RepkaWisthi/VESC-V.2/reference/bldc-hardware-master/bldc-hardware-master/design/PNGs/B_Modules-1.png

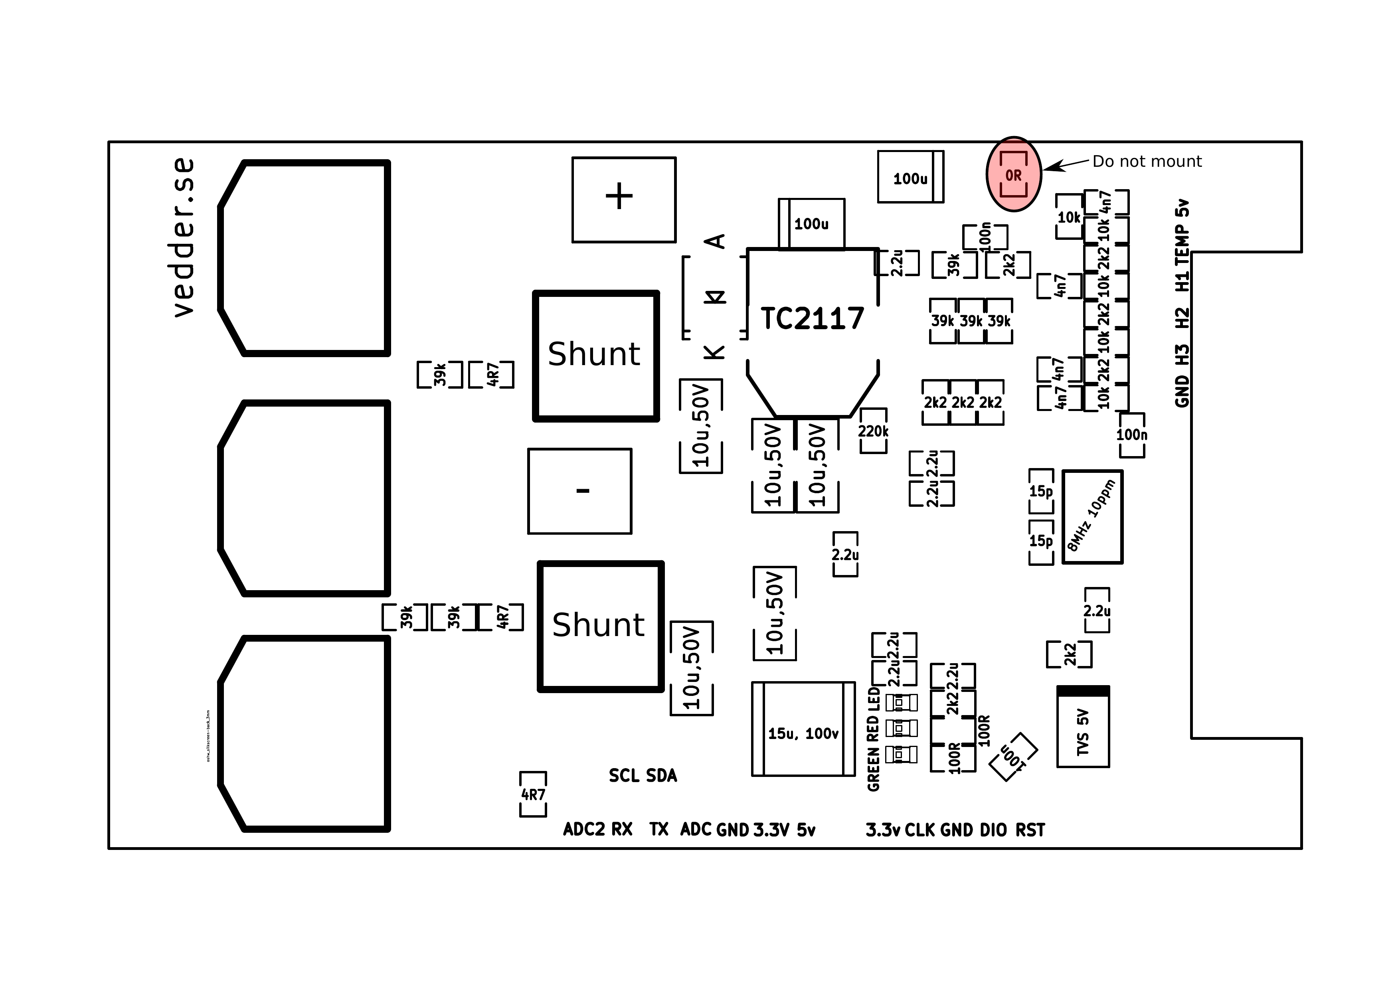
reference/bldc-hardware-master/bldc-hardware-master/design/PNGs/B_Modules-1.png
