RepkaWisthi/VESC-V.2/reference/bldc-hardware-master/bldc-hardware-master/design/PNGs/Schematic-6.png

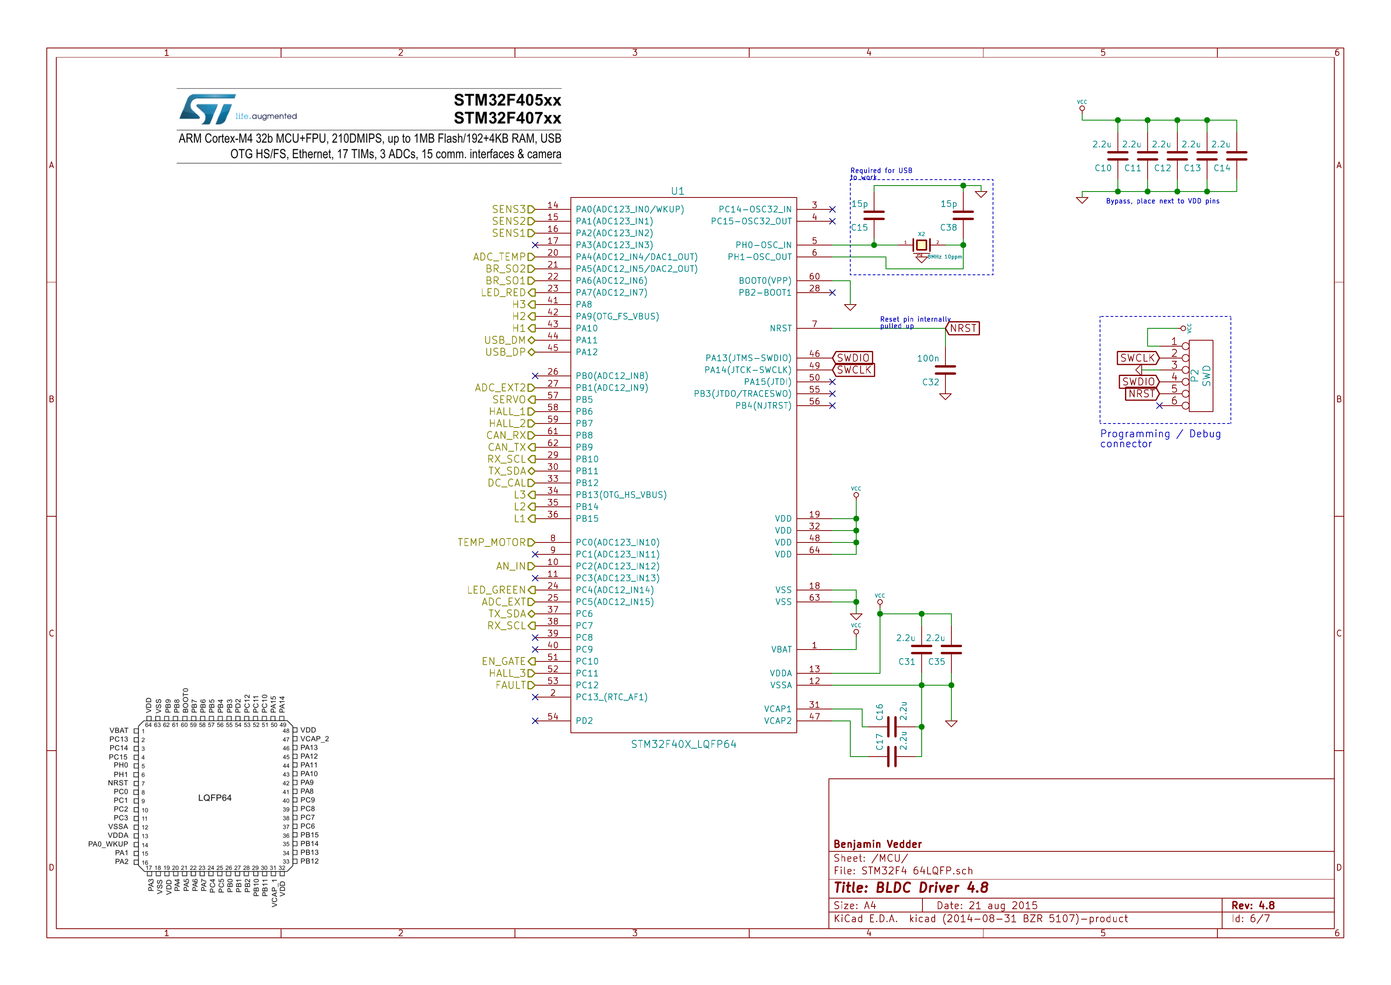
reference/bldc-hardware-master/bldc-hardware-master/design/PNGs/Schematic-6.png
