RepkaWisthi/VESC-V.2/reference/bldc-hardware-master/bldc-hardware-master/design/PNGs/vesc_back_silk_neg.png

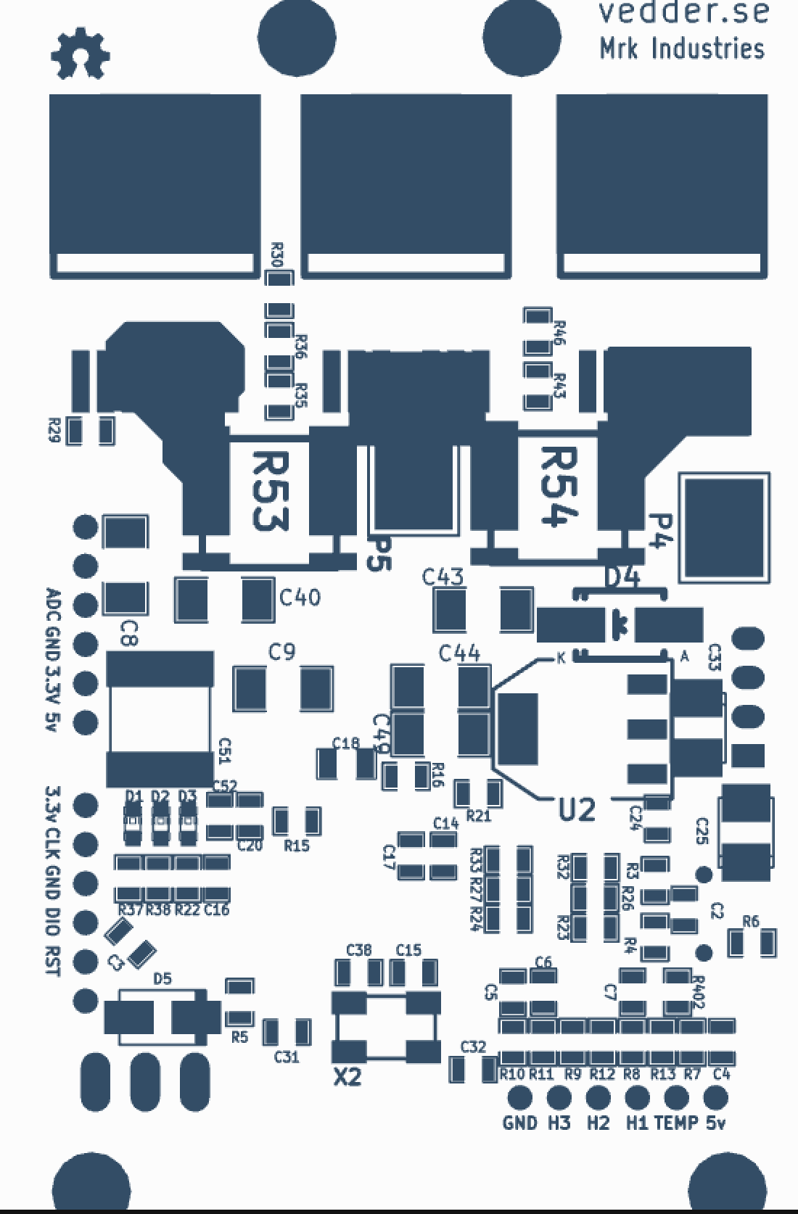
reference/bldc-hardware-master/bldc-hardware-master/design/PNGs/vesc_back_silk_neg.png
