RepkaWisthi/VESC-V.2/3D asset/IRFS7530TRL7PP/PG-TO263-7_INF.step

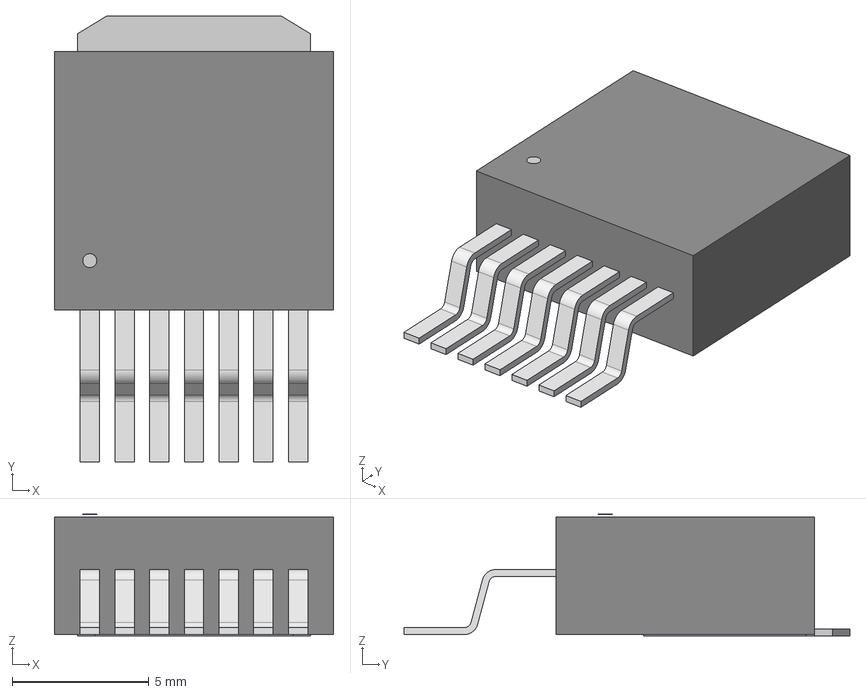
[picture p16: CAD file, 2025-01-07]
3D asset/IRFS7530TRL7PP/PG-TO263-7_INF.step
10.2 x 16.3 x 4.45 mm
