RepkaWisthi/VESC-V.2/3D asset/JST - XH - Thru (V) - 7Pin - 2.54mm.stp

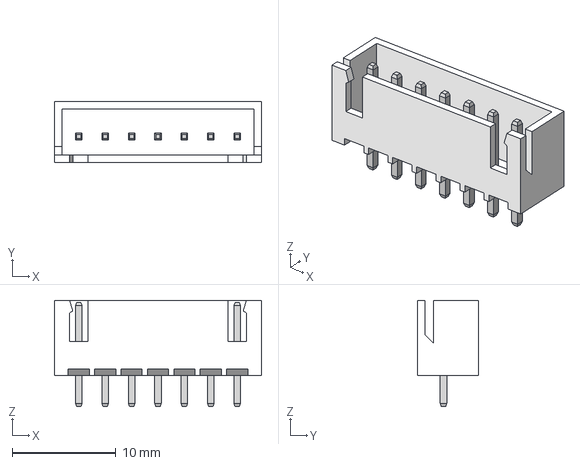
[picture p17: CAD file, 2025-01-07]
3D asset/JST - XH - Thru (V) - 7Pin - 2.54mm.stp
19.9 x 5.84 x 10.2 mm
