RepkaWisthi/VESC-V.2/3D asset/Component1.step

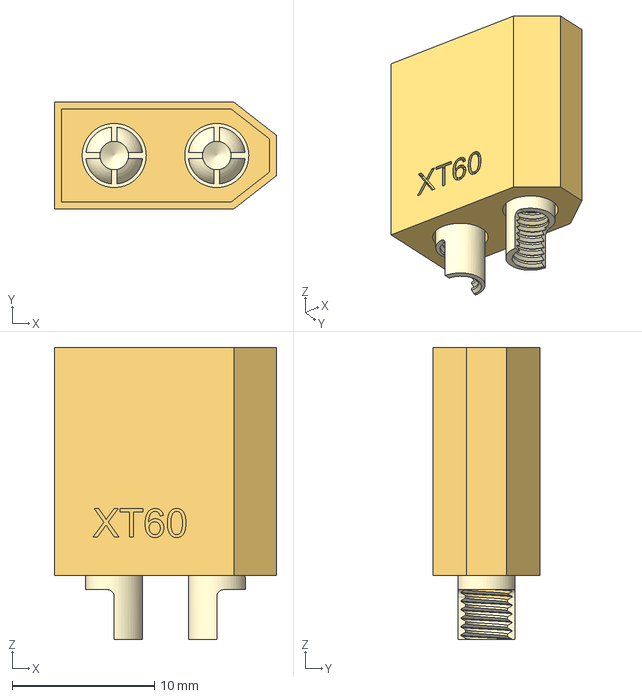
[picture p18: CAD file, 2025-01-07]
3D asset/Component1.step
15.6 x 7.50 x 20.5 mm
