RepkaWisthi/VESC-V.2/3D asset/JST - XH - Thru (V) - 4Pin - 2.54mm.stp

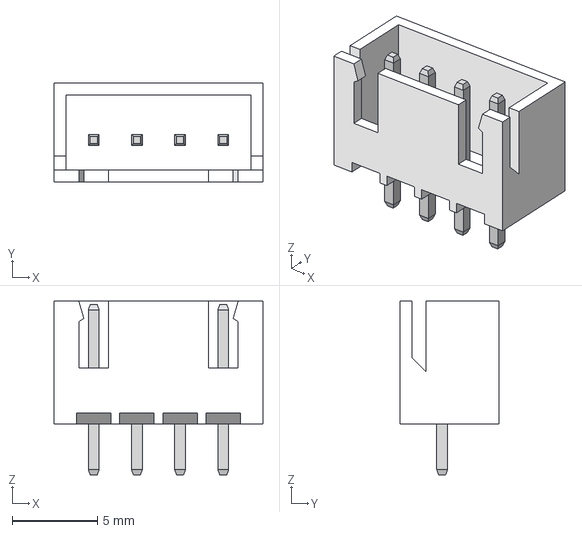
[picture p20: CAD file, 2025-01-07]
3D asset/JST - XH - Thru (V) - 4Pin - 2.54mm.stp
12.3 x 5.84 x 10.2 mm
