RepkaWisthi/VESC-V.2/3D asset/C2220.STEP

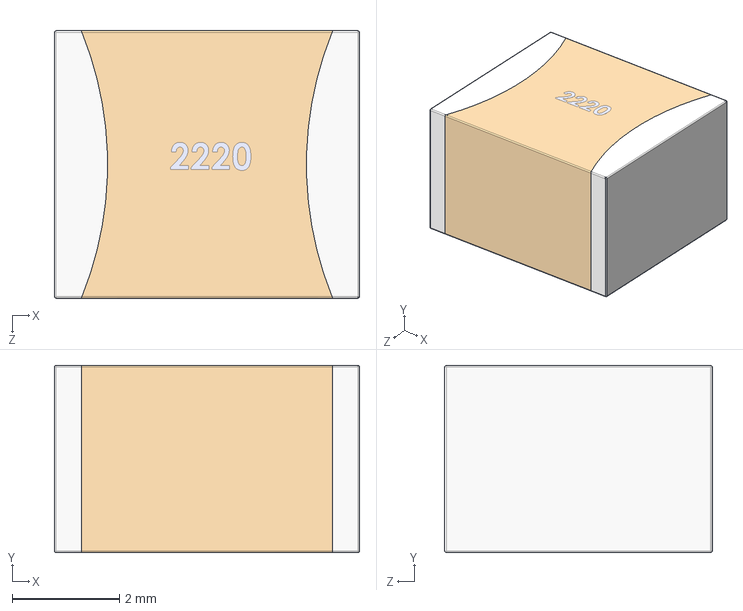
[picture p21: CAD file, 2025-01-07]
3D asset/C2220.STEP
5.70 x 3.50 x 5.00 mm
