RepkaWisthi/VESC-V.2/3D asset/DRV8302DCA.STEP

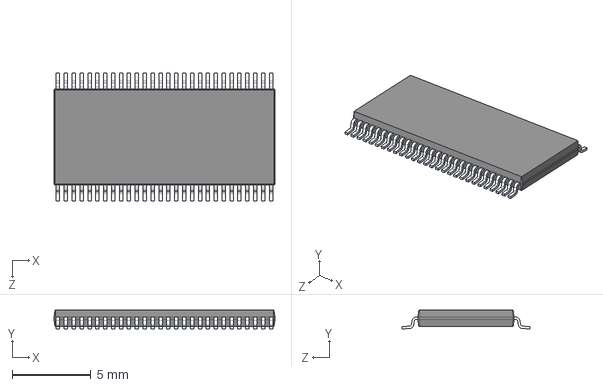
[picture p22: CAD file, 2025-01-07]
3D asset/DRV8302DCA.STEP
14.0 x 1.20 x 8.10 mm
