RepkaWisthi/VESC-V.2/3D asset/STM32F405RGT6.step

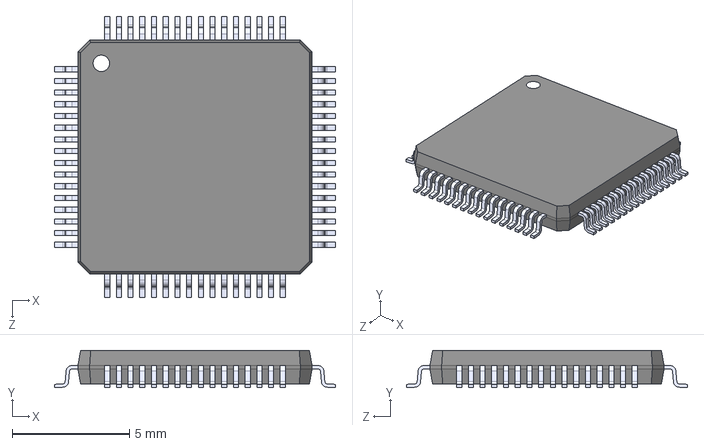
[picture p23: CAD file, 2025-01-07]
3D asset/STM32F405RGT6.step
12.0 x 1.60 x 12.0 mm
