RepkaWisthi/VESC-V.2/3D asset/SN65HVD232DR.STEP

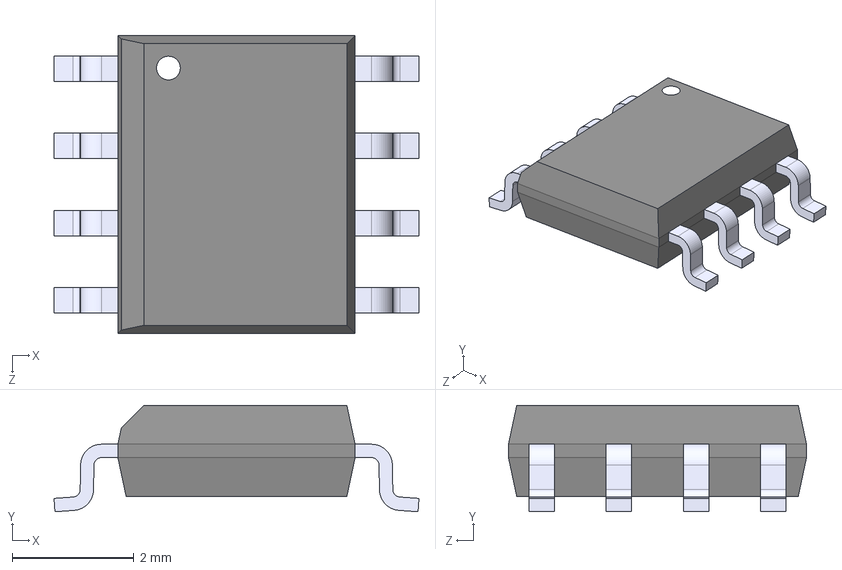
[picture p25: CAD file, 2025-01-07]
3D asset/SN65HVD232DR.STEP
6.00 x 1.75 x 4.90 mm
