RepkaWisthi/VESC-V.2/3D asset/JST - XH - Thru (V) - 6Pin - 2.54mm.stp

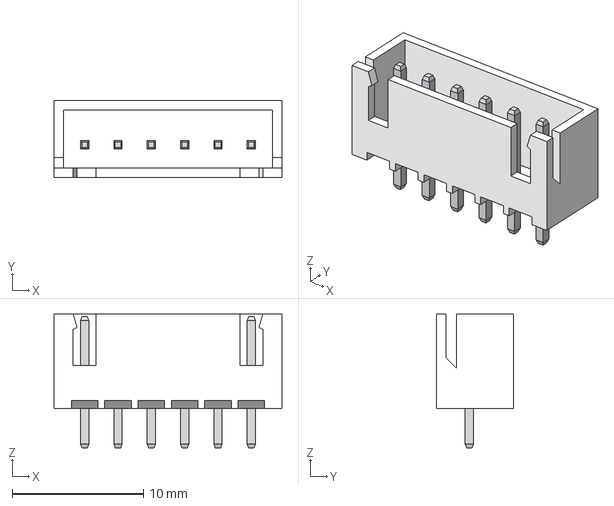
[picture p26: CAD file, 2025-01-07]
3D asset/JST - XH - Thru (V) - 6Pin - 2.54mm.stp
17.4 x 5.84 x 10.2 mm
