RepkaWisthi/VESC-V.2/VESC V.2.kicad_pcb

## KiCad design VESC V.2.kicad_pcb (2025-02-11)

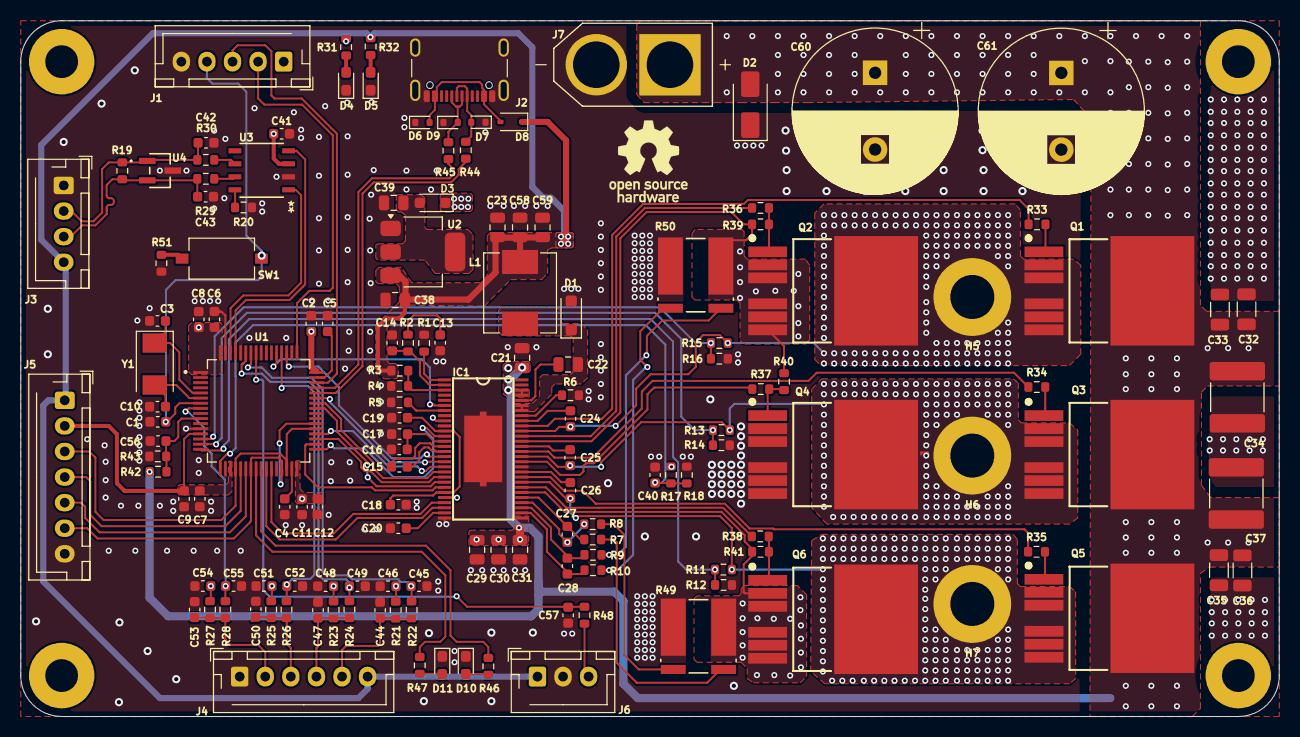
[picture p27: board VESC V.2.kicad_pcb from above]

Board: 4 copper layers, 123.0 x 68.0 mm, 151 parts (0 on the bottom side), 102 nets.

Parts:
C1, C46, C48, C51, C54, C56, C57: 100nF; C_0603_1608Metric
C2, C4, C5, C6, C7, C8, C9, C11, C12, C16, C17, C18, C19, C20, C40, C41: 2.2uF; C_0603_1608Metric
C3, C10: 15pF; C_0603_1608Metric
C13: 6.8nF; C_0603_1608Metric
C14: 120pF; C_0603_1608Metric
C15: 22nF; C_0603_1608Metric
C21: 10uF/100V; C_0805_2012Metric
C22: 100nF; C_0805_2012Metric
C23, C38, C58, C59: 10uF; C_0805_2012Metric
C24, C25, C26: 220nF; C_0603_1608Metric
C27, C28: 2.2nF; C_0603_1608Metric
C29, C30, C31: 10uF/50V; C_0805_2012Metric
C32, C33, C35, C36: 10uF/50V; C_1206_3216Metric
C34, C37: 15uF/100V; C_2220_5750Metric
C39: 22uF; C_0805_2012Metric
C42, C43: 51pF; C_0603_1608Metric
C44, C45, C47, C49, C50, C52, C53, C55: 4.7nF; C_0603_1608Metric
C60, C61: 820uF/80V; CP_Radial_D16.0mm_P7.50mm
D1: PMEG6020; D_SOD-123F
D2: SMAJ60A; D_SMA
D3: BAT60A; D_SOD-323_HandSoldering
D4, D11: GREEN; LED_0603_1608Metric_Pad1.05x0.95mm_HandSolder
D5: RED; LED_0603_1608Metric_Pad1.05x0.95mm_HandSolder
D6, D7, D9: LESD5D5.0CT1G; D_SOD-523
D8: BAT760-7; D_SOD-323
D10: BLUE; LED_0603_1608Metric_Pad1.05x0.95mm_HandSolder
H1, H2, H3, H4: MountingHole_Pad; MountingHole_3.2mm_M3_Pad
H5, H6, H7: MountingHole_Pad; MountingHole_4.3mm_M4_ISO7380_Pad
IC1: DRV8302; TSSOP-56_3
J1: Conn_01x05_Socket; JST_XH_B5B-XH-AM_1x05_P2.50mm_Vertical
J2: USB_C_Receptacle_USB2.0_16P; USB_C_Receptacle_GCT_USB4105-xx-A_16P_TopMnt_Horizontal
J3: CAN BUS; JST_XH_B4B-XH-AM_1x04_P2.50mm_Vertical
J4: HALL SENSOR; JST_XH_B6B-XH-AM_1x06_P2.50mm_Vertical
J5: Conn_01x07_Socket; JST_XH_B7B-XH-AM_1x07_P2.50mm_Vertical
J6: Conn_01x03_Socket; JST_XH_B3B-XH-AM_1x03_P2.50mm_Vertical
J7: XT60-M; AMASS_XT60-M
L1: 22uH; L_Chilisin_BMRB00060612
Q1, Q2, Q3, Q4, Q5, Q6: IRFS7530TRL7PP; TO127P1524X483-7N
R1: 220K; R_0603_1608Metric
R2: 15K; R_0603_1608Metric
R3: 18K; R_0603_1608Metric
R4: 3.3K; R_0603_1608Metric
R5, R18, R20, R22, R24, R26, R28: 10K; R_0603_1608Metric
R6: 1M; R_0603_1608Metric
R7, R8, R9, R10: 100R; R_0603_1608Metric
R11, R13, R15, R39, R40, R41, R42: 39K; R_0603_1608Metric
R12, R14, R16: 2k2; R_0603_1608Metric
R17: NTC_10K; R_0603_1608Metric
R19: 120R; R_0603_1608Metric
R21, R23, R25, R27, R43, R48, R51: 2.2K; R_0603_1608Metric
R29, R30: 10R; R_0603_1608Metric
R31, R32, R46, R47: 1K; R_0603_1608Metric
R33, R34, R35, R36, R37, R38: 4R7; R_0603_1608Metric
R44, R45: 22R; R_0603_1608Metric
R49, R50: 1m; WSLP2726_1mOHM_VIS
SW1: SW_Push; SW_Tactile_SPST_NO_Straight_CK_PTS636Sx25SMTRLFS
U1: STM32F405RGT6; QFP50P1200X1200X160-64N
U2: AMS1117-3.3; SOT-223-3_TabPin2
U3: SN65HVD232DR; D8-L
U4: ESDCAN24-2BLY; SOT_24-2BLY_STM-M
Y1: 8MHz 10ppm; Crystal_SMD_Abracon_ABM3-2Pin_5.0x3.2mm

Connections:
+5V: C23.2, C38.1, C58.2, C59.2, D8.1 (K), J3.4, J4.6, J5.1, J6.1, L1.2, R3.1, R32.1, U2.3 (VI)
/CAN BUS/CANH: C43.2, J3.3, R19.1, R29.2, U4.2
/CAN BUS/CANL: C42.1, J3.2, R19.2, R30.2, U4.1
/CAN BUS/CAN_RX: U1.61 (PB8), U3.4 (R)
/CAN BUS/CAN_TX: U1.62 (PB9), U3.1 (D)
/HALL_FILTER/HALL1_IN: C44.1, J4.5, R21.2, R22.1
/HALL_FILTER/HALL1_OUT: C45.1, R22.2, U1.58 (PB6)
/HALL_FILTER/HALL2_IN: C47.1, J4.4, R23.2, R24.1
/HALL_FILTER/HALL2_OUT: C49.1, R24.2, U1.59 (PB7)
/HALL_FILTER/HALL3_IN: C50.1, J4.3, R25.2, R26.1
/HALL_FILTER/HALL3_OUT: C52.1, R26.2, U1.52 (PC11)
/HALL_FILTER/TEMP_IN: C53.1, J4.2, R27.2, R28.1
/HALL_FILTER/TEMP_OUT: C55.1, R28.2, U1.8 (PC0)
/MCU/ADC_TEMP: C40.1, R17.2, R18.1, U1.17 (PA3/USART2_RX)
/MCU/AN_IN: C56.1, R42.2, R43.1, U1.10 (PC2/SPI2_MISO)
/MCU/BR_S01: IC1.25 (SO1), U1.27 (PB1)
/MCU/BR_S02: IC1.26 (SO2), U1.26 (PB0)
/MCU/DC_CAL: IC1.12 (DC_CAL), U1.33 (PB12)
/MCU/EN_GATE: IC1.16 (EN_GATE), U1.51 (PC10)
/MCU/FAULT: IC1.6 (~FAULT), U1.53 (PC12)
/MCU/H1: IC1.17 (INH_A), U1.43 (PA10)
/MCU/H2: IC1.19 (INH_B), U1.42 (PA9)
/MCU/H3: IC1.21 (INH_C), U1.41 (PA8)
/MCU/L1: IC1.18 (INL_A), U1.36 (PB15)
/MCU/L2: IC1.20 (INL_B), U1.35 (PB14)
/MCU/L3: IC1.22 (INL_C), U1.34 (PB13)
/MCU/LED_GREEN: R47.1, U1.24 (PC4)
/MCU/LED_RED: R46.1, U1.25 (PC5)
/MCU/MISO_ADC_EXT2: J5.5, U1.22 (PA6/SPI1_MISO)
/MCU/RX_SCL_MOSI: J5.6, U1.23 (PA7/SPI1_MOSI), U1.29 (PB10), U1.38 (PC7)
/MCU/SCK_ADC_EXT: J5.4, U1.21 (PA5/SPI1_SCK)
/MCU/SENS1: R11.1, R12.1, U1.16 (PA2/USART2_TX)
/MCU/SENS2: R13.1, R14.1, U1.15 (PA1/USART2_RTS)
/MCU/SENS3: R15.1, R16.1, U1.14 (PA0/WKUP)
/MCU/SERVO: C57.1, R48.1, U1.57 (PB5)
/MCU/TX_SDA_NSS: J5.3, U1.20 (PA4/USART2_CK), U1.30 (PB11), U1.37 (PC6)
/MCU/USB_D+: R45.2, U1.45 (PA12)
/MCU/USB_D-: R44.2, U1.44 (PA11)
/MOSFET DRIVER/H1_VS: C24.2, H5.1, IC1.46 (SH_A), Q1.2, Q1.3, Q1.5, Q1.6, Q1.7, Q2.4, R15.2
/MOSFET DRIVER/H2_VS: C25.2, H6.1, IC1.41 (SH_B), Q3.2, Q3.3, Q3.5, Q3.6, Q3.7, Q4.4, R13.2
/MOSFET DRIVER/H3_LOW: IC1.34 (SL_C), Q6.2, Q6.3, Q6.5, Q6.6, Q6.7, R41.1, R49.1
/MOSFET DRIVER/H3_VS: C26.2, H7.1, IC1.36 (SH_C), Q5.2, Q5.3, Q5.5, Q5.6, Q5.7, Q6.4, R11.2
/MOSFET DRIVER/HI_LOW: IC1.44 (SL_A), Q2.2, Q2.3, Q2.5, Q2.6, Q2.7, R39.1, R40.1, R50.1
/MOSFET DRIVER/M_H1: IC1.47 (GH_A), R33.1
/MOSFET DRIVER/M_H2: IC1.42 (GH_B), R34.1
/MOSFET DRIVER/M_H3: IC1.37 (GH_C), R35.1
/MOSFET DRIVER/M_L1: IC1.45 (GL_A), R36.1
/MOSFET DRIVER/M_L2: IC1.40 (GL_B), R37.1
/MOSFET DRIVER/M_L3: IC1.35 (GL_C), R38.1
/MOSFET DRIVER/SH1_A: R7.2, R49.2
/MOSFET DRIVER/SH1_B: R8.2, R49.3
/MOSFET DRIVER/SH2_A: R9.2, R50.2
/MOSFET DRIVER/SH2_B: R10.2, R50.3
GND: C1.1, C2.1, C3.2, C4.2, C5.2, C6.1, C7.1, C8.1, C9.1, C10.2, C11.1, C12.1, C13.1, C14.1, C16.1, C17.1, C18.1, C19.1, C20.1, C21.2, C23.1, C29.1, C30.1, C31.1, C32.2, C33.2, C34.2, C35.2, C36.2, C37.2, C38.2, C39.2, C40.2, C41.2, C42.2, C43.1, C44.2, C45.2, C46.2, C47.2, C48.2, C49.2, C50.2, C51.2, C52.2, C53.2, C54.2, C55.2, C56.2, C57.2, C58.1, C59.1, C60.2, C61.2, D1.2 (A), D2.1 (A1), D4.1 (K), D5.1 (K), D6.1 (A1), D7.1 (A1), D9.1 (A1), D10.1 (K), D11.1 (K), IC1.8 (M_PWM), IC1.10 (GAIN), IC1.28 (AGND), IC1.39 (SL_B), IC1.57 (AGND), IC1.58 (AGND), IC1.59 (AGND), J1.5, J2.A1 (GND), J2.A12 (GND), J2.B1 (GND), J2.B12 (GND), J2.S1 (SHIELD), J3.1, J4.1, J5.7, J6.2, J7.N (NEG), Q4.2, Q4.3, Q4.5, Q4.6, Q4.7, R1.1, R4.1, R5.1, R6.2, R12.2, R14.2, R16.2, R18.2, R20.1, R43.2, R49.4, R50.4, R51.1, U1.12 (VSSA), U1.18 (VSS), U1.60 (BOOT0), U1.63 (VSS__1), U2.1 (GND), U3.2 (GND), U4.3
NRST: C1.2, J1.4, SW1.2, U1.7 (NRST)
unnamed: C13.2, R2.1
unnamed: C22.2, D1.1 (K), IC1.50 (PH), IC1.51 (PH), L1.1
unnamed: C39.1, D3.2 (A), U2.2 (VO)
unnamed: D4.2 (A), R31.2
unnamed: D5.2 (A), R32.2
unnamed: D6.2 (A2), D8.2 (A), J2.A4 (VBUS), J2.A9 (VBUS), J2.B4 (VBUS), J2.B9 (VBUS)
unnamed: D7.2 (A2), J2.A7 (D-), J2.B7 (D-), R44.1
unnamed: D9.2 (A2), J2.A6 (D+), J2.B6 (D+), R45.1
unnamed: D10.2 (A), R46.2
unnamed: D11.2 (A), R47.2
unnamed: C20.2, IC1.27 (AVDD)
unnamed: IC1.49 (BIAS), R6.1
unnamed: C24.1, IC1.48 (BST_A)
unnamed: C25.1, IC1.43 (BST_B)
unnamed: C22.1, IC1.52 (BST_BK)
unnamed: C26.1, IC1.38 (BST_C)
unnamed: C14.2, IC1.2 (COMP), R2.2
unnamed: C15.2, IC1.14 (CP1)
unnamed: C15.1, IC1.15 (CP2)
unnamed: IC1.7 (DTC), R5.2
unnamed: C18.2, C19.2, IC1.11 (OC_ADJ), IC1.23 (DVDD)
unnamed: C16.2, C17.2, IC1.13 (GVDD)
unnamed: IC1.1 (RT_CLK), R1.2
unnamed: C27.1, IC1.33 (SN1), R7.1
unnamed: C28.1, IC1.31 (SN2), R9.1
unnamed: C27.2, IC1.32 (SP1), R8.1
unnamed: C28.2, IC1.30 (SP2), R10.1
unnamed: IC1.3 (VSENSE), R3.2, R4.2
unnamed: J6.3, R48.2
unnamed: Q1.1, R33.2
unnamed: Q2.1, R36.2, R39.2
unnamed: Q3.1, R34.2
unnamed: Q4.1, R37.2, R40.2
unnamed: Q5.1, R35.2
unnamed: Q6.1, R38.2, R41.2
unnamed: R20.2, U3.8 (NC)
unnamed: R51.2, SW1.1
unnamed: C3.1, U1.5 (PH0/OSC_IN), Y1.1
unnamed: C10.1, U1.6 (PH1/OSC_OUT), Y1.2
unnamed: C4.1, U1.31 (VCAP_1)
unnamed: C5.1, U1.47 (VCAP_2)
unnamed: R29.1, U3.7 (CANH)
unnamed: R30.1, U3.6 (CANL)
SWCLK: J1.2, U1.49 (PA14/JTCK-SWCLK)
SWDIO: J1.3, U1.46 (PA13/JMS-SWDIO)
VCC: C2.2, C6.2, C7.2, C8.2, C9.2, C11.2, C12.2, C41.1, C46.1, C48.1, C51.1, C54.1, D3.1 (K), IC1.9 (M_OC), IC1.24 (REF), J1.1, J5.2, R17.1, R21.1, R23.1, R25.1, R27.1, R31.1, U1.1 (VBAT), U1.13 (VDDA), U1.19 (VDD), U1.32 (VDD__1), U1.48 (VDD__2), U1.64 (VDD__3), U3.3 (VCC)
V_SUPPLY: C21.1, C29.2, C30.2, C31.2, C32.1, C33.1, C34.1, C35.1, C36.1, C37.1, C60.1, C61.1, D2.2 (A2), IC1.29 (PVDD1), IC1.53 (PVDD2), IC1.54 (PVDD2), J7.P (POS), Q1.4, Q3.4, Q5.4, R42.1
