RepkaWisthi/VESC-V.2/reference/bldc-hardware-master/bldc-hardware-master/design/temp.sch

## KiCad design reference/bldc-hardware-master/bldc-hardware-master/design/temp.sch (2025-01-07)


Parts:
C41: 2.2u; SMD-0603_c
R1: NTC 10k; SMD-0603_r
R2: 10k; SMD-0603_r

Connections:
GND: C41.2, R2.2
Temp: C41.1, R1.2, R2.1
VCC: R1.1
