RepkaWisthi/VESC-V.2/(commit log)

2025-01-07 Initial commit for VESC V.2
    [BLDC4.12_BOM.ods, BLDC_4-2024-11-25-20-50-50.sch, BLDC_4-2024-11-27-19-09-24.sch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]
2025-01-07 add open hardware logo
    [VESC V.2.kicad_pcb]
2025-01-11 ready for review
    1. finish routing
    2. finish silkscreen adjustment
    3. finish DRC and ERC
    [MCU.kicad_sch, MOSFET DRIVER.kicad_sch, VESC V.2.kicad_pcb, VESC V.2.kicad_sch]
